LEB-EPFL/basic_training/README.md

# Microscopy Basic Training




Resources for the microscopy basic training course in the [Laboratory of Experimental Biophysics](https://www.epfl.ch/labs/leb/).
