LEB-EPFL/basic_training/arduino_src/README.md

# Arduino Source

Arduino source code files.

- [led_matrix_controller](led_matrix_controller) : The controller for the LED matrix
- [led_pwm_driver](led_pwm_driver) : A PWM driver for the epi-fluorescence LEDs
