LEB-EPFL/basic_training/book/src/chapter_live_cell_mito/startup/README.md

# Microscope Startup

We will begin by starting up the microscope and its components.

## Instructions

### Step 0

Turn on the air pump and the environmental controls for the incubator.

It is good practice to turn these on 10 minutes or more before any experiment so that the environmental controls have a chance to stabilize.

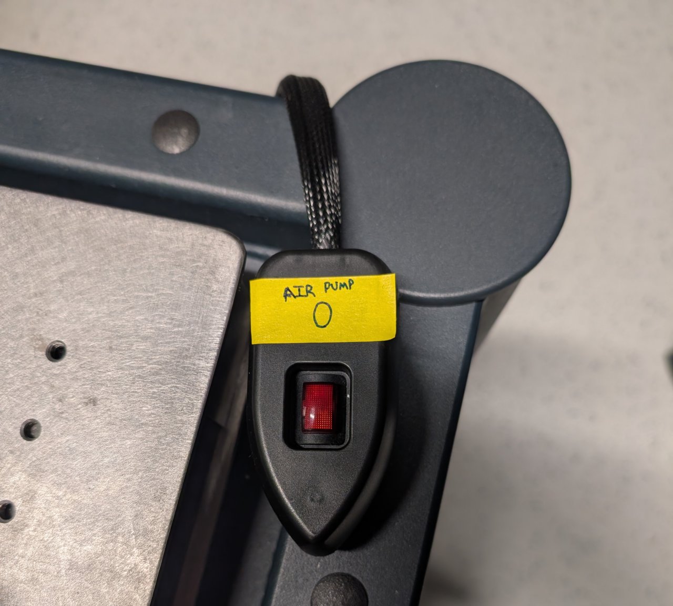
[picture p14: book/src/chapter_live_cell_mito/startup/step_0.jpg]

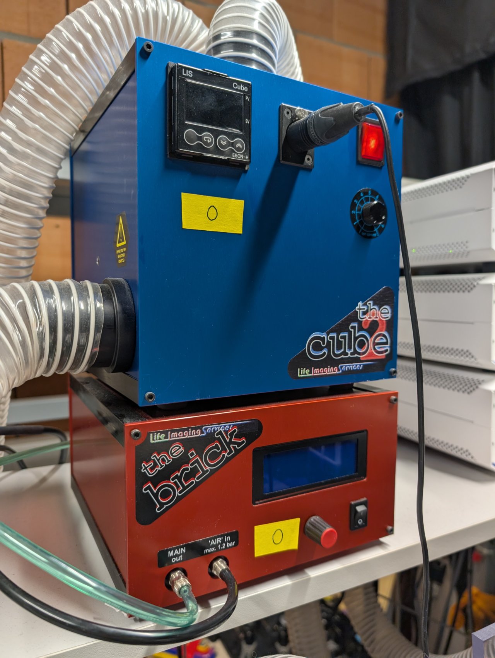
[picture p15: book/src/chapter_live_cell_mito/startup/step_1.jpg]


### Step 1

Turn on the focus controller for the Zeiss's Definite Focus system.

In addition, turn on the Zeiss's Power Supply 232 and SMC 2009 controllers.

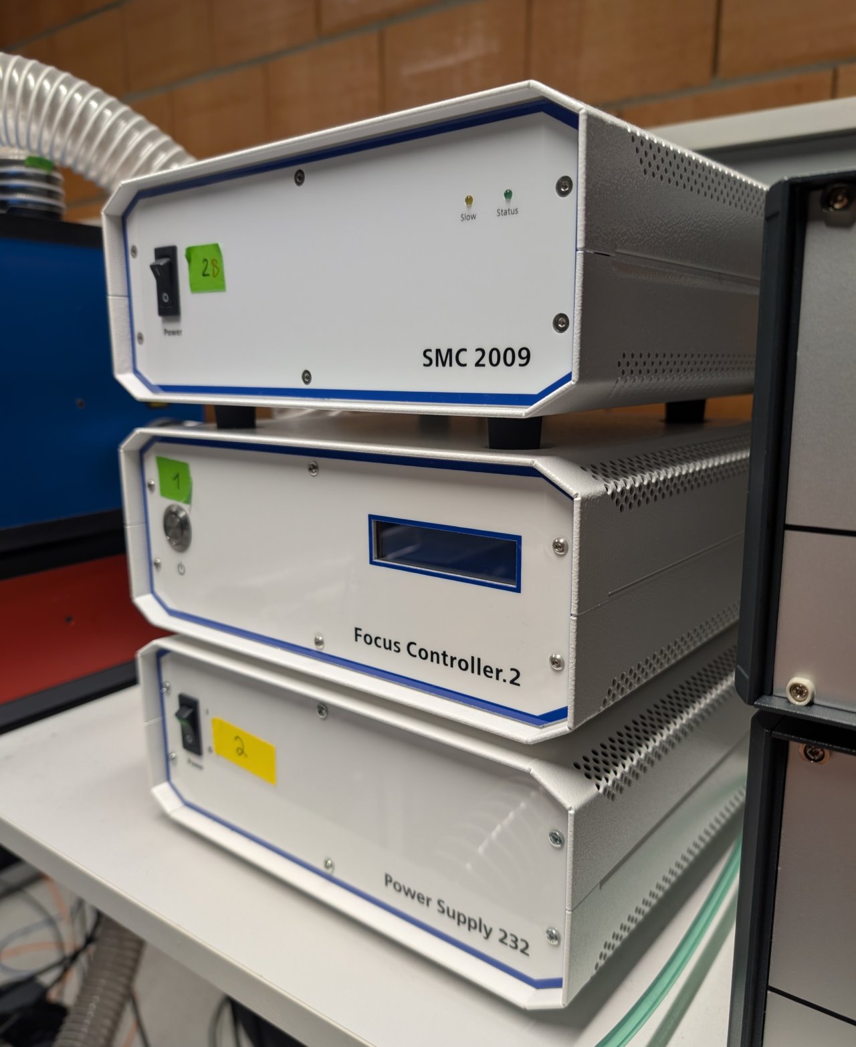
[picture p16: book/src/chapter_live_cell_mito/startup/step_2.jpg]


### Step 2

Turn on the CoolLED unit.

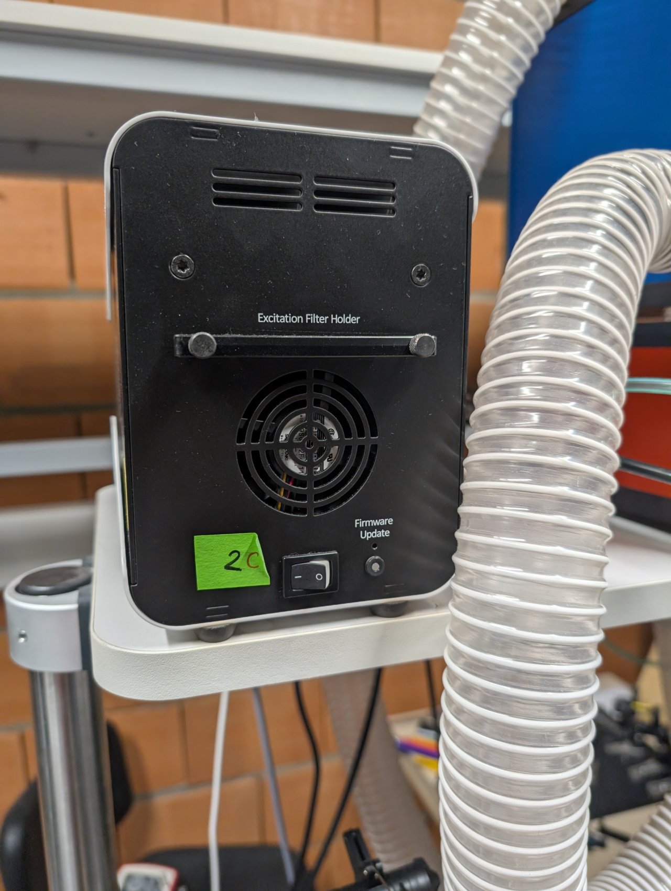
[picture p17: book/src/chapter_live_cell_mito/startup/step_3.jpg]


### Step 3

Turn on the camera. You need not wait for the initialization to finish before turning on the control PC because the camera is connected via USB.

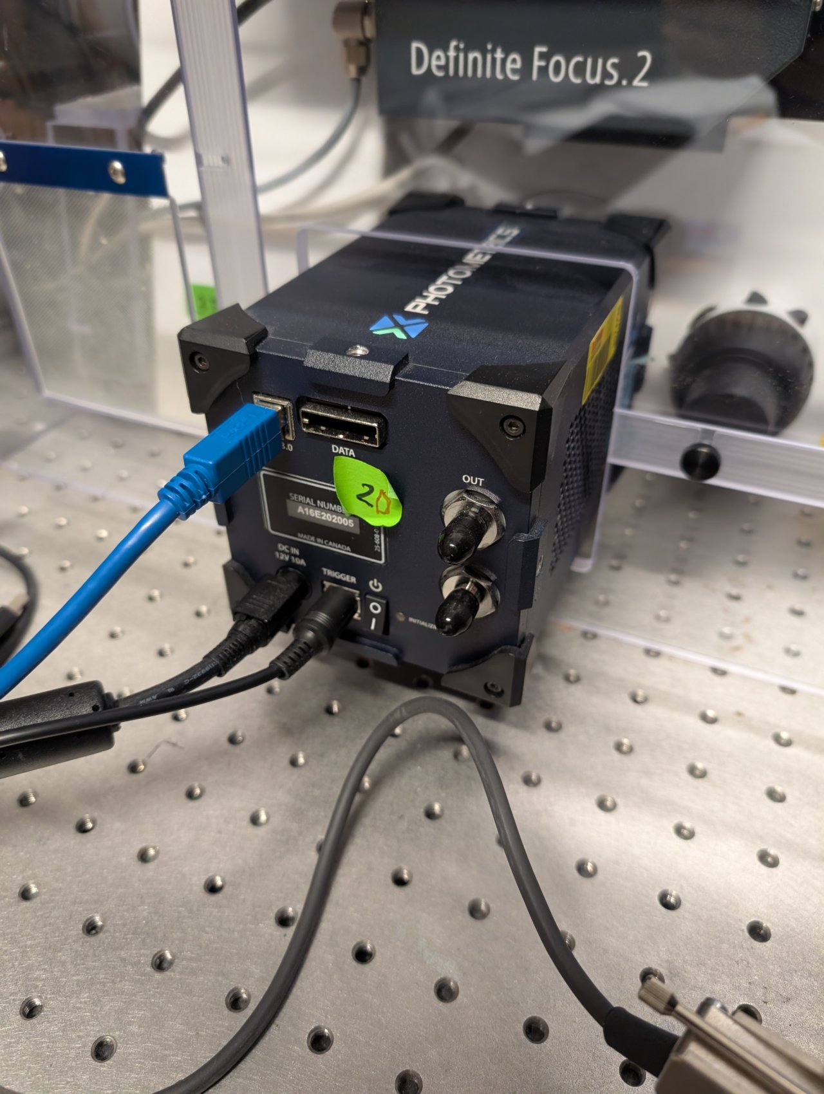
[picture p18: book/src/chapter_live_cell_mito/startup/step_4.jpg]


### Step 4

Wait until the Definite Focus controller's initialization has finished. (You can tell whether it has finished because it will no longer display a message indicating that it is initializing on its LCD display screen.)

Turn on the microscope.

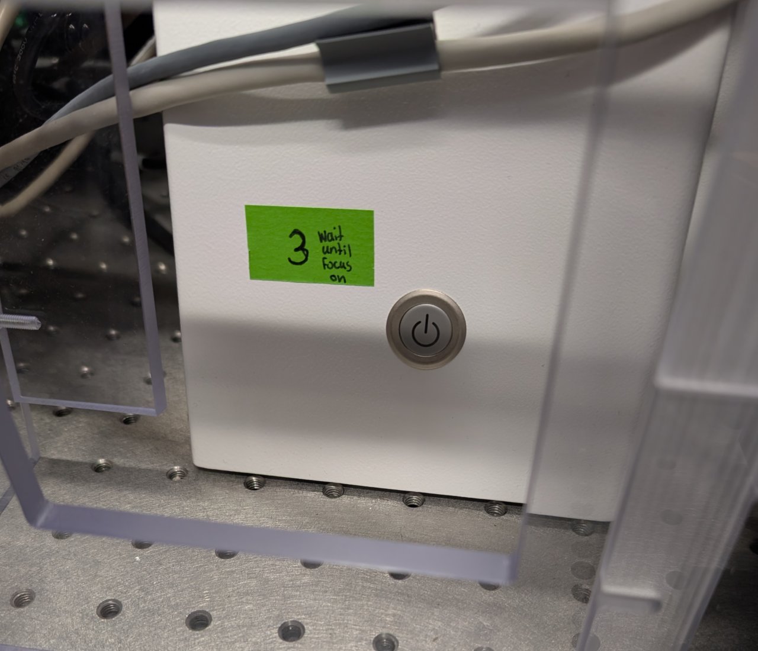
[picture p19: book/src/chapter_live_cell_mito/startup/step_5.jpg]


### Step 5

Log into the computer with your EPFL username.

Find the shortcut to Micro-Manager on the desktop and double click it.

*2025-12-05*: This shortcut should point to `C:\Program Files\Micro-Manager-2.0\ImageJ.exe`. It is a slightly out-of-date version of Micro-Manager that is intended to support the CoolLED light source.

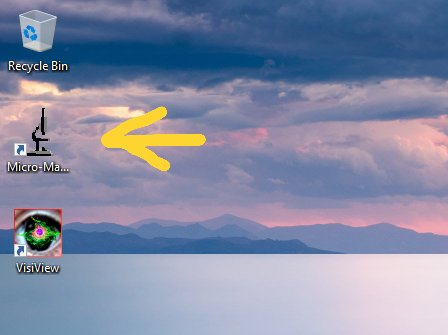
[picture p20: book/src/chapter_live_cell_mito/startup/step_7.jpg]

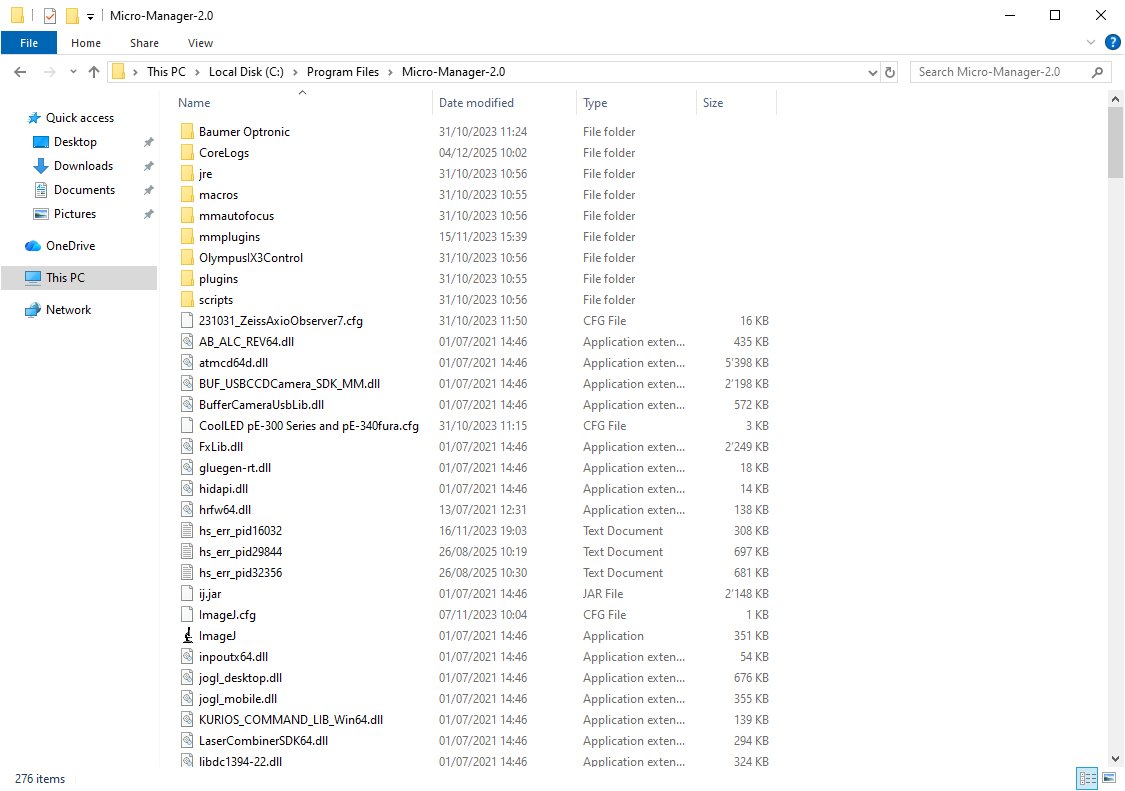
[picture p21: book/src/chapter_live_cell_mito/startup/step_6.jpg]


### Step 6

After a few seconds or less You will see the Micro-Manager startup screen. Ensure that the `231031_ZeissAxioObserver7.cfg` configuration file is selected. We have placed it inside the Micro-Manager folder in case you must select it yourself.

Click `OK` to continue.

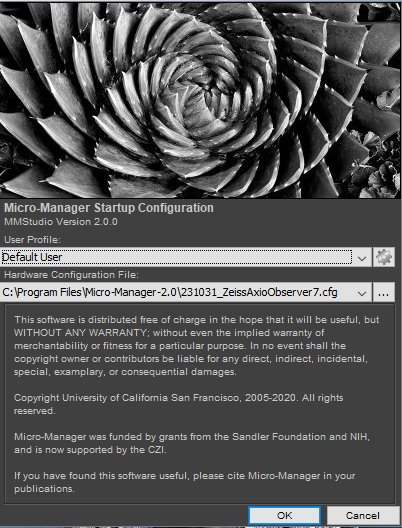
[picture p22: book/src/chapter_live_cell_mito/startup/step_8.jpg]


### Step 7

After a few more seconds, you will see the Micro-Manager control panel. If you do not see all the configuration settings at first, then expand the window by dragging its border.

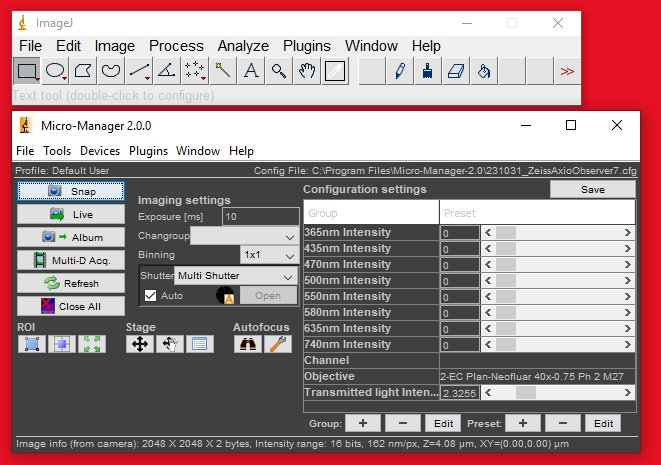
[picture p23: book/src/chapter_live_cell_mito/startup/step_9.jpg]


### Step 8

You can set the channel and objective by selecting the corresponding configuration settings in the control panel.

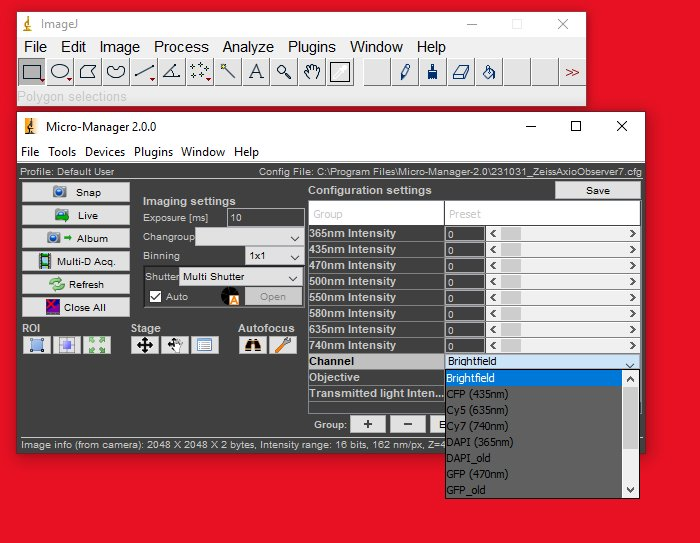
[picture p24: book/src/chapter_live_cell_mito/startup/step_10.jpg]


### Step 9

Click the `Live` button. If you see a noisy image stream appear, then you are ready to proceed to the next steps.

### Step 10

Push back the condenser tower. It is a bit difficult and does not rotate easily.

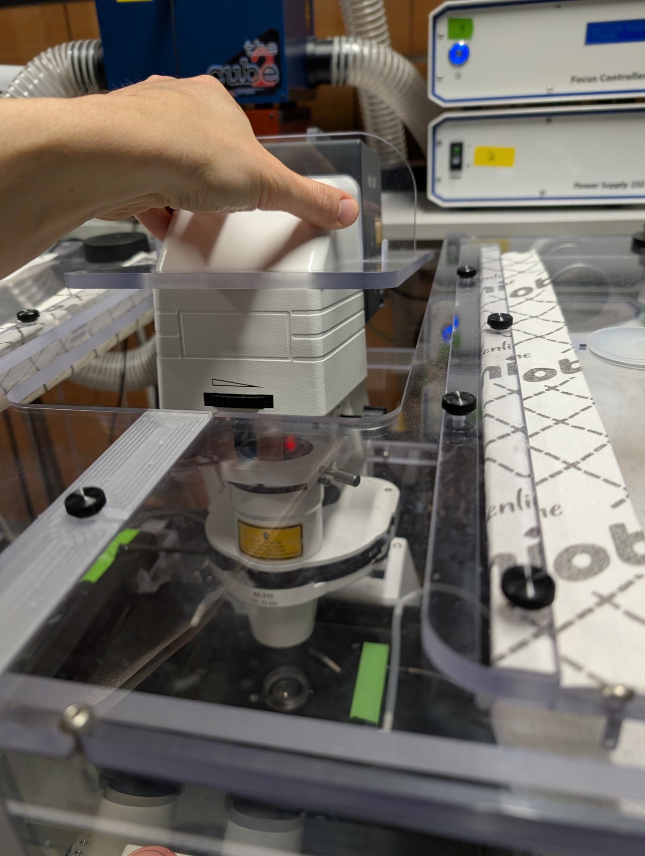
[picture p25: book/src/chapter_live_cell_mito/startup/step_11.jpg]


### Step 11

**Make sure that you are using the 63x oil immersion objective.** If not, use the control panel to switch to it.

Add a small drop of 37 C immersion oil to the lens, and put your sample in the solid bottom plate. Put the plate into the opening in the microscope stage.

Secure the sample dish with a metal clip.

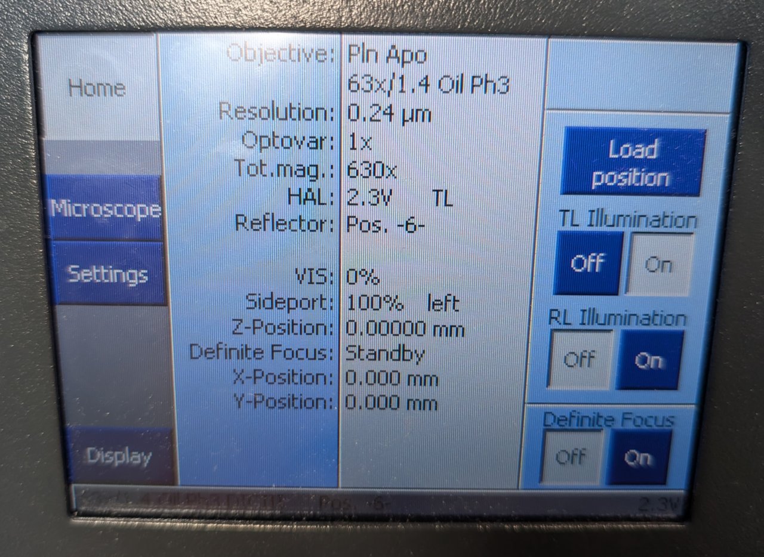
[picture p26: book/src/chapter_live_cell_mito/startup/step_00.jpg]

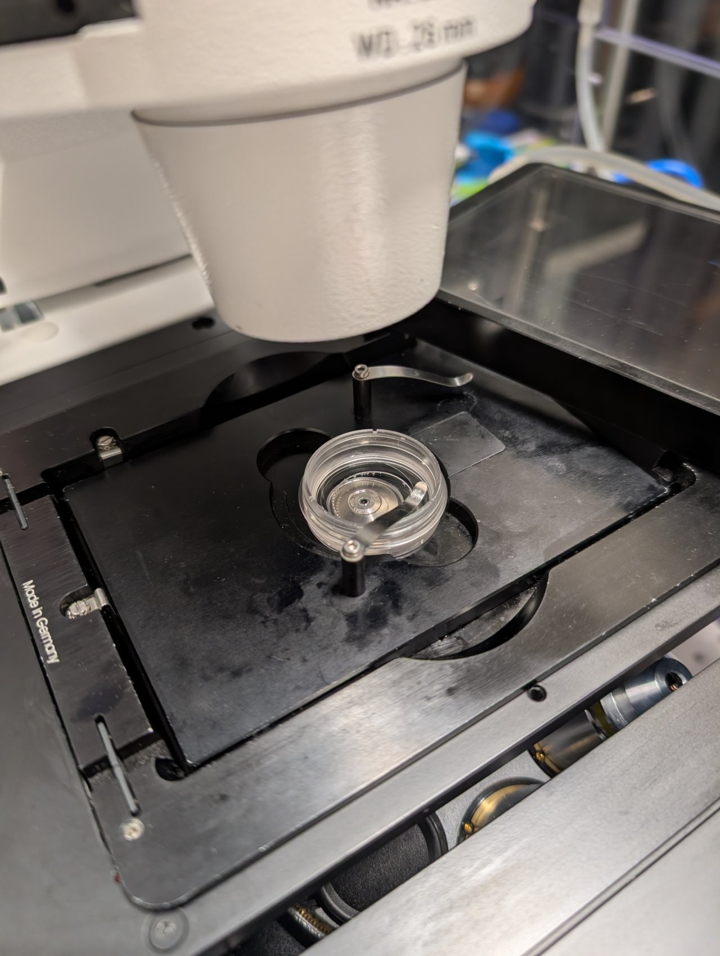
[picture p27: book/src/chapter_live_cell_mito/startup/step_12.jpg]


### Step 12

Cover the sample dish with the CO2 chamber.

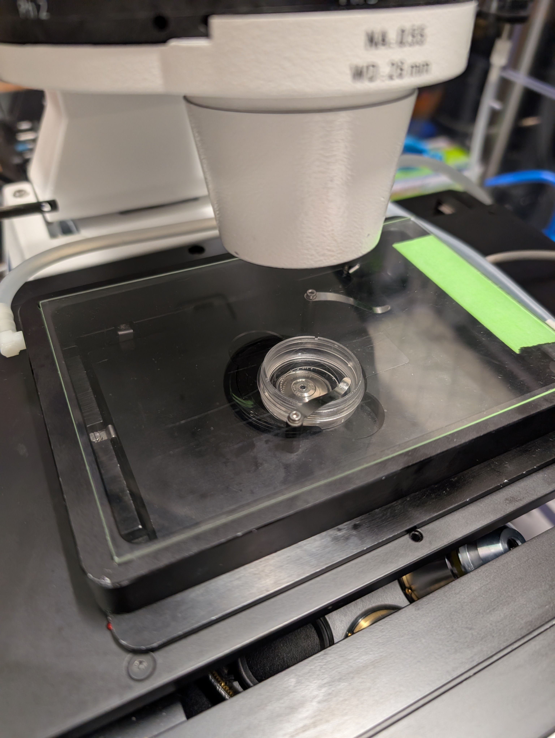
[picture p28: book/src/chapter_live_cell_mito/startup/step_13.jpg]
