LEB-EPFL/basic_training/book/src/SUMMARY.md

# Summary

- [Introduction](./chapter_intro/README.md)
  - [Learning Outcomes](./chapter_intro/learning_outcomes.md)
- [Live Cell Fluorescence Imaging of Mitochondria](./chapter_live_cell_mito/README.md)
  - [The Epifluorescence Microscope](./chapter_live_cell_mito/microscope_components.md)
  - [Start up the Microscope](./chapter_live_cell_mito/startup/README.md)
  - [Set up Köhler Illumination](./chapter_live_cell_mito/koehler/README.md)
  - [Image the Cells in Fluorescence](./chapter_live_cell_mito/fluorescence/README.md)
  - [Discussion](./chapter_live_cell_mito/discussion/README.md)
  - [Questions](./chapter_live_cell_mito/questions.md)
- [Microscope Optics and Image Acquisition](./chapter_image_acquisition/README.md)
  - [Set up the Camera](./chapter_image_acquisition/camera.md)
  - [Align the Camera and Tube Lens](./chapter_image_acquisition/camera_tube_lens_alignment.md)
  - [Set up Micro-Manager](./chapter_image_acquisition/micro-manager.md)
  - [Discussion](./chapter_image_acquisition/discussion.md)
  - [Questions](./chapter_image_acquisition/questions.md)
- [Alignment](./chapter_alignment/README.md)
  - [Construct the Microscope Emission Path](./chapter_alignment/emission_path/README.md)
  - [Control the Laser](./chapter_alignment/laser_control/README.md)
  - [Construct the Microscope Excitation Path](./chapter_alignment/excitation_path/README.md)
  - [Discussion](./chapter_alignment/discussion.md)
- [Further Reading](./chapter_further_reading/README.md)
