LEB-EPFL/basic_training/arduino_src/led_matrix_controller/led_matrix_controller.ino

#include <Adafruit_Protomatter.h>

#include "comms.h"
#include "drawing.h"

/// Communications configuration
const uint32_t BAUD = 115200;
const uint8_t OK    = 0;
const uint8_t ERROR = 1;

/// LED matrix configuration and commands
const uint8_t MATRIX_SIZE = 32;
const uint8_t BIT_DEPTH   = 4;

uint8_t rgbPins[]  = {2, 3, 4, 5, 6, 7};
uint8_t addrPins[] = {A0, A1, A2, A3};
uint8_t clockPin   = 8;
uint8_t latchPin   = 10;
uint8_t oePin      = 9;

// Prints a help message to the screen.
//
// Update this function if LINE_TERMINATOR changes.
void printHelp() {
  Serial.println(F("Available commands:"));
  Serial.println(F("  draw <x> <y> (0 - 255)\\n"));
  Serial.println(F("  fill (0 - 255)\\n"));
  Serial.println(F("  brightfield <x> <y> <r> (0 - 255)\\n"));
  Serial.println(F("  darkfield <x> <y> <r> (0 - 255)\\n"));
  Serial.println(F("  halfMoon <x> <y> <r> (0 - 3) (0 - 255)\\n"));
  Serial.println(F("  ring <x> <y> <r> <r2> (0 - 255)\\n"));
  Serial.println(F("  help\\n"));
  Serial.println(F(""));
  Serial.println("Note: commands must be terminated with a \\n character.");
}

/// Main program
Adafruit_Protomatter matrix(MATRIX_SIZE, BIT_DEPTH, 1, rgbPins, 4, addrPins, clockPin, latchPin, oePin, false);
String input;
Message msg;

void setup() {
  Serial.begin(BAUD);

  messageInit(msg);

  // Initialize LED matrix
  ProtomatterStatus status = matrix.begin();
  Serial.print("Protomatter begin() status: ");
  Serial.println((int)status);
  if(status != PROTOMATTER_OK) {
    for(;;);
  }
}

void loop() {
  if (readStringUntil(input, LINE_TERMINATOR, CHAR_LIMIT)) {
    parseMessage(input, msg);
    if (msg.isValid) {
      doAction(msg, matrix);
      Serial.print(String(OK) + LINE_TERMINATOR);
    } else {
      Serial.println(msg.errorMsg);
      printHelp();
      Serial.print(String(ERROR) + LINE_TERMINATOR);
    }

    // Clear the input buffer to prepare for the next line.
    input = "";
  }
}

void doAction(const Message& msg, Adafruit_Protomatter& matrix) {
  switch (msg.cmd) {
    case Command::draw:
      draw(msg, matrix);
      break;
    case Command::fill:
      fill(msg, matrix);
      break;
    case Command::brightfield:
      brightfield(msg, matrix);
      break;
    case Command::darkfield:
      darkfield(msg, matrix);
      break;
    case Command::halfMoon:
      halfMoon(msg, matrix);
      break;
    case Command::ring:
      ring(msg, matrix);
      break;
    case Command::help:
      printHelp();
      break;
    default:
      break;
  }
}
