LEB-EPFL/basic_training/(commit log)

2025-07-08 Add Arduino code for the LED array
2025-07-08 Add Arduino smoke tests
2025-07-10 Add ring pattern to LED matrix controller
2025-07-11 Add a PWM-based LED driver for epifluorescence (#1)
    * Add LED PWM driver to Arduino sketches
    * Add README for LED driver
    * Add GH Actions compilation check for LED driver
2025-08-08 Write the section on microscope components (#3)
    * Add sketch of an epifluorscence microscope
    * Write epifluorescence microscope section
    * Fix typo in TOC
    * Begin camera section with description of the driver installation
    * Finish the camera driver section
2025-08-29 Add RS232 commands docs for the Sapphire laser
2025-09-23 Finish camera setup chapter
2025-09-23 Add parts list for FFL camera
2025-09-25 Add images showing initial tube lens assembly setup
2025-09-25 Add image of translating camera
2025-09-26 Finalize steps in FFL assembly
2025-09-29 Finish emission path sub assembly.
2025-12-01 Refactor material placing fluorescence microscopy first in the chapters
